kudou917/musical_instrument/sketch_piano/piano.md

# キーパッドに特定の音をそれぞれ割り当てて音を出力するテスト

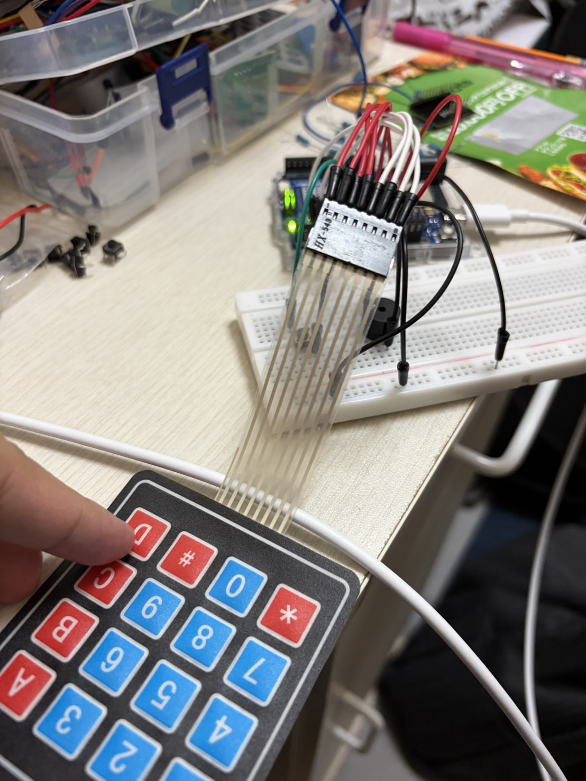
[picture p6: sketch_piano/S__17661959.jpg]
写真


[演奏動画](802596416.173644.mp4)

以上の画像の通りであるが、基本プロジェクトのキーパッドと基本は同様。画像では視認しにくいが、パッシブブザーとオクターブを上げるためのタクトスイッチをブレッドボードから接続している。

キーパッドの方で使っているキーは12～13ほどしかないのでうまくいけば7ピンまで使用ピンを減らすことが出来る。

## ソースコード

```cpp

/*
  The code use an Adafruit Keypad and display keypress events via the Serial Monitor.
  It initializes the keypad with a 4x4 layout, where each key is represented by a
  specific character. It continuously checks for keypad events (key press or release)
  and prints the corresponding key and event status to the Serial Monitor.

  Board: Arduino Uno R4
  Component:  Keypad
  Library: https://github.com/adafruit/Adafruit_Keypad (Adafruit Keypad by Adafruit)
*/

// Include the Adafruit_Keypad library
#define TONE_USE_INT
#define TONE_PITCH 440
#include <TonePitch.h>
#include "Adafruit_Keypad.h"
#define BUZZ_PIN 13 // ブザーのピン
#define bot 7
// Define the number of rows and columns for the keypad
const byte ROWS = 4;
const byte COLS = 4;

// Define the characters mapped to each button on the 4x4 keypad
char keys[ROWS][COLS] = {
    {'1', '2', '3', 'A'},
    {'4', '5', '6', 'B'},
    {'7', '8', '9', 'C'},
    {'*', '0', '#', 'D'}};

// Define the Arduino pins connected to the row pinouts of the keypad
byte rowPins[ROWS] = {2, 3, 4, 5};
// Define the Arduino pins connected to the column pinouts of the keypad
byte colPins[COLS] = {8, 9, 10, 11};

// Initialize a custom keypad instance
Adafruit_Keypad myKeypad = Adafruit_Keypad(makeKeymap(keys), rowPins, colPins, ROWS, COLS);

void buzzSound(int frequency)
{
    tone(BUZZ_PIN, frequency); // 音を鳴らす
    delay(50);
}

// Setup function
void setup()
{
    // Initialize Serial communication at 9600 baud rate
    Serial.begin(9600);
    // Initialize the custom keypad
    myKeypad.begin();
    pinMode(bot, INPUT_PULLUP);
    pinMode(BUZZ_PIN, OUTPUT);
}

// Main loop function
void loop()
{
    // Update the state of keys
    myKeypad.tick();

    // Check if there are new keypad events
    while (myKeypad.available())
    {
        // Read the keypad event
        keypadEvent e = myKeypad.read();
        // Print the key that triggered the event
        Serial.println((char)e.bit.KEY);
        // Print the type of event: pressed or released

        if (e.bit.EVENT == KEY_JUST_RELEASED)
        {
            noTone(BUZZ_PIN);
        }
        else if (digitalRead(bot) == LOW)
        {
            switch ((char)e.bit.KEY)
            {
            case '1':
                buzzSound(NOTE_C5);
                break;
            case '2':
                buzzSound(NOTE_CS5);
                break;
            case '3':
                buzzSound(NOTE_D5);
                break;
            case 'A':
                buzzSound(NOTE_DS5);
                break;
            case '4':
                buzzSound(NOTE_E5);
                break;
            case '5':
                buzzSound(NOTE_F5);
                break;
            case '6':
                buzzSound(NOTE_FS5);
                break;
            case '7':
                buzzSound(NOTE_G5);
                break;
            case '8':
                buzzSound(NOTE_GS5);
                break;
            case '9':
                buzzSound(NOTE_A5);
                break;
            case 'C':
                buzzSound(NOTE_AS5);
                break;
            case '*':
                buzzSound(NOTE_B5);
                break;
            case '0':
                buzzSound(NOTE_C6);
                break;
            }
        }
        else
        {
            switch ((char)e.bit.KEY)
            {
            case '1':
                buzzSound(NOTE_C4);
                break;
            case '2':
                buzzSound(NOTE_CS4);
                break;
            case '3':
                buzzSound(NOTE_D4);
                break;
            case 'A':
                buzzSound(NOTE_DS4);
                break;
            case '4':
                buzzSound(NOTE_E4);
                break;
            case '5':
                buzzSound(NOTE_F4);
                break;
            case '6':
                buzzSound(NOTE_FS4);
                break;
            case '7':
                buzzSound(NOTE_G4);
                break;
            case '8':
                buzzSound(NOTE_GS4);
                break;
            case '9':
                buzzSound(NOTE_A4);
                break;
            case 'C':
                buzzSound(NOTE_AS4);
                break;
            case '*':
                buzzSound(NOTE_B4);
                break;
            case '0':
                buzzSound(NOTE_C5);
                break;
            }
        }

        delay(10);
    }
}

```

6/17
キーパッドピアノをB♭キーにした。
