kudou917/musical_instrument/sketch_piano/plan.md

【5V電源】 ───┬───────┬───────┬───────┐
              │       │       │       │
            [SW1]   [SW2]   [SW3]   [SW4]  (タクトスイッチ)
              │       │       │       │
            [1kΩ]   [2kΩ]   [4.3kΩ] [8.2kΩ]* (重み付け抵抗)
              │       │       │       │
【A0ピン】 ───┴───────┴───────┴───────┼─── [1kΩ] ───【GND】
                                      (基準プルダウン抵抗)
