kudou917/musical_instrument/handa/handa.md

# はんだメッキによる練習結果

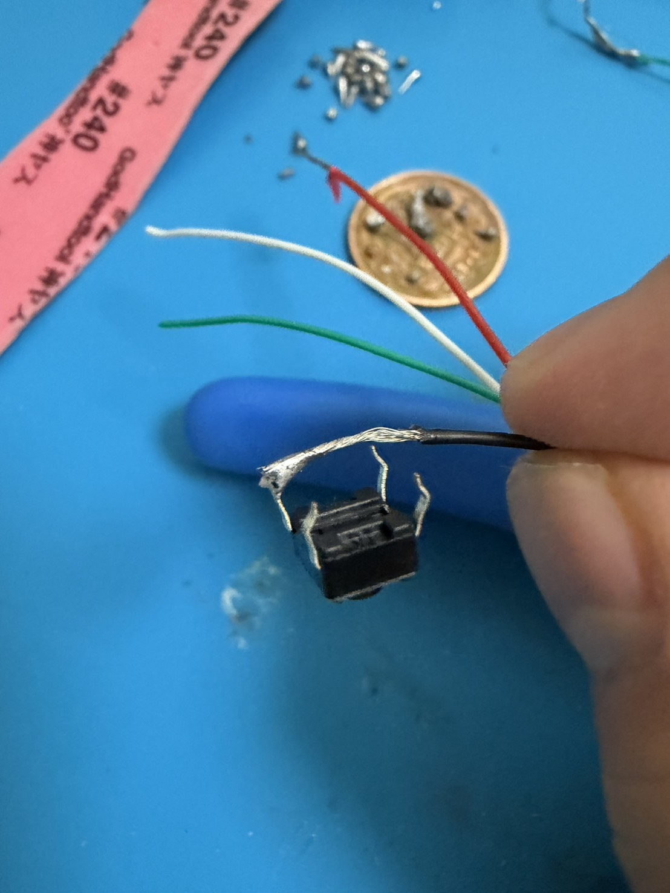
[picture p9: handa/image-1.png]


# 本番

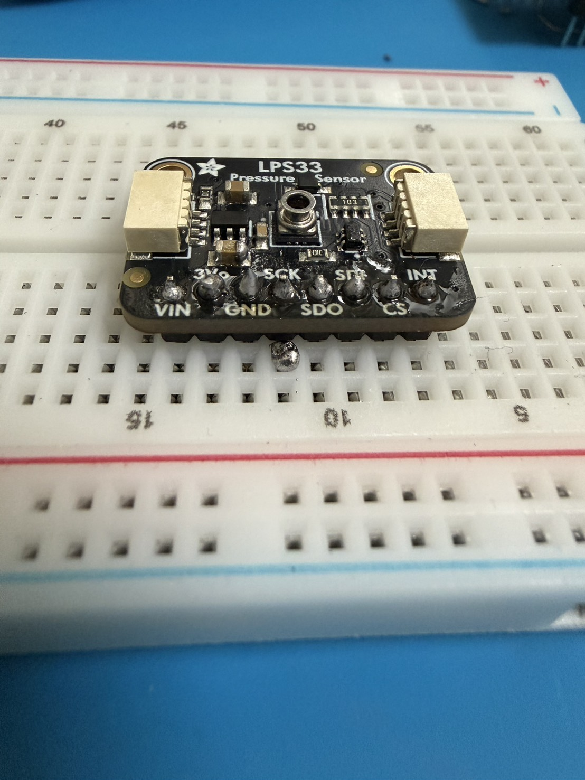
[picture p10: handa/image.png]


正常に動作したためこちらで作業を行う。
