kudou917/musical_instrument/haisen/haisen.md

# 概要

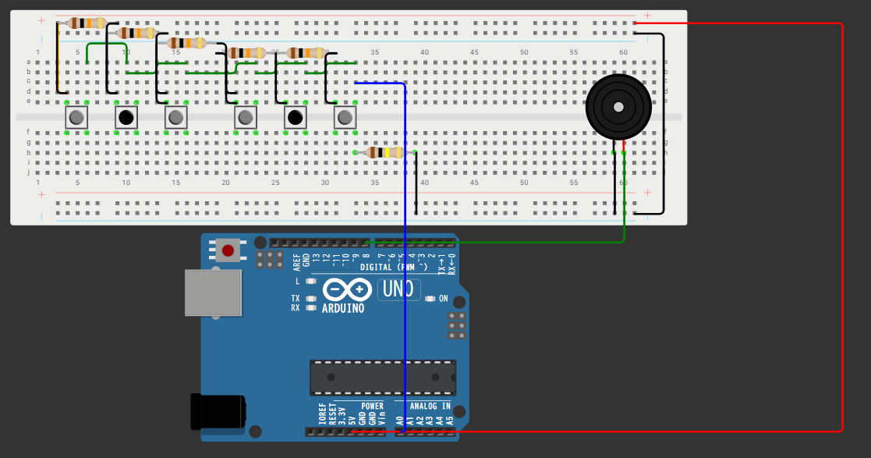
[picture p11: haisen/image.png]


配線は以上の通りである。ラダー型回路を採用し、ボタンは7つ。黒いボタンの部分は半音（ピアノで言う黒鍵）である。
今回のこの楽器は移調しており通常Ｃ（ド）が置いてある位置にシ♭（Ｂ♭）を配置するプラグラムにしている。  

このブレッドボードは下管であり、ブレッドボードが届き次第上管の配線。後に上下巻の連結を行う。  

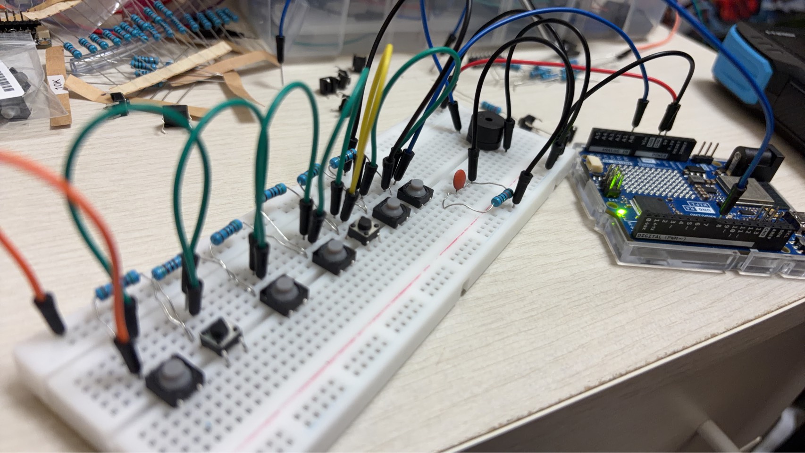
[picture p12: haisen/S__17940483.jpg]


## 問題点

- ジャズや最近のポップスの様な複雑なフレーズをやろうとしたときに音がワンテンポ遅れてしまうのが難点。  
- delay(100)より細かくすると配線の方が入力に追いつけずノイズの幅が大きくなってしまう。
- 配線の調子が悪いと数値が変動してしまい想定されていた音とは別の物が出る場合がある。
