kudou917/musical_instrument/image-1.png

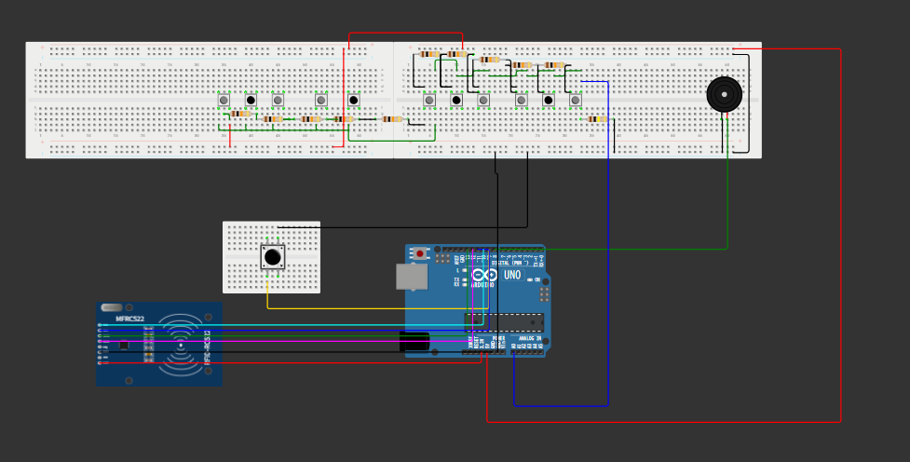
image-1.png
