kudou917/musical_instrument/haisen/haisen.cpp

#define TONE_USE_INT
#define TONE_PITCH 440
#include <TonePitch.h>

const int SENSOR_PIN = A0;
const int BUZZ_PIN = 8;
void setup() {
    Serial.begin(115200);
    pinMode(BUZZ_PIN,OUTPUT);
    pinMode(SENSOR_PIN,INPUT);
}

void loop() {
    int value = analogRead(SENSOR_PIN);

    Serial.println(value);
  if ((value >= 1000) && (1024 >= value)){
    buzzSound(NOTE_A4);
  }
  else if ((value >= 850) && (890 >= value)){
    buzzSound(NOTE_GS4);
  }
  else if ((value >= 725) && (750 >= value)){
    buzzSound(NOTE_G4);
  }
  else if ((value >= 625) && (650 >= value)){
    buzzSound(NOTE_F4);
  }
  else if ((value >= 540) && (580 >= value)){
    buzzSound(NOTE_FS4);
  }
  else if ((value >= 460) && (525 >= value)){
    buzzSound(NOTE_DS4);
  }
  else if ((value >= 400) && (450 >= value)){
    buzzSound(NOTE_E4);
  }
   else if ((value >= 340) && (380 >= value)){
    buzzSound(NOTE_D4);
  }
   else if ((value >= 290) && (335 >= value)){
    buzzSound(NOTE_C4);
  }
   else if ((value >= 230) && (280 >= value)){
    buzzSound(NOTE_CS4);
  }
   else if ((value >= 180) && (200 >= value)){
    buzzSound(NOTE_AS3);
  }
    else if ((value >= 110) && (165 >= value)){
    buzzSound(NOTE_B3);
  }
  else{   //何も押されてない時
    noTone(BUZZ_PIN);   //消音
  }
    delay(100);
}

void buzzSound(int frequency){
  tone(BUZZ_PIN, frequency);  //音を鳴らす
  delay(50);
}
