kudou917/musical_instrument/(commit log)

2026-06-08 電子ピアノのソースコードの追加
2026-06-10 キーパッドでの音出しのテスト
2026-06-16 フローチャート
2026-06-17 センサーテスト、キーパッドピアノの追加
2026-06-17 レポート更新
2026-07-01 参考サイトの更新
2026-07-16 はんだ付けについて
2026-07-16 空気圧センサーについての説明
